J-CE/womo-energie-zentrale/src/config.h

#pragma once
#define FW_VERSION "5.6.7"
#define DEFAULT_TZ                  "CET-1CEST,M3.5.0,M10.5.0/3"   // Europe/Berlin
#define SERIAL_BAUD                 115200
#define UART_BMS_PORT               1
#define UART_BMS_RX                 16
#define UART_BMS_TX                 17
#define UART_BMS_BAUD               115200
#define UART_MPPT_PORT              2
#define UART_MPPT_RX                38
#define UART_MPPT_TX                42          // neu v5.0 (war -1)
#define UART_MPPT_BAUD              19200
#define GPIO_WR_LED_POWER           4     // Power-LED (grün), über Spannungsteiler
#define GPIO_WR_LED_ALARM           5     // Alarm-LED (rot),  über Spannungsteiler
#define WR_LED_ACTIVE               HIGH  // nach Messung ggf. auf LOW ändern
#define SPI_SD_CS                   11
#define SPI_SD_CLK                  12
#define SPI_SD_MOSI                 13
#define SPI_SD_MISO                 14
#define I2C_RTC_SDA                 1
#define I2C_RTC_SCL                 2
#define LEVEL_I2C_ADDR_PRIMARY      0x1D        // SA0=1 (Default-Breakout)
#define LEVEL_I2C_ADDR_ALT          0x1C        // SA0=0
#define LEVEL_POLL_INTERVAL_MS      250         // 4 Hz — flüssiges Leveling
#define LEVEL_TOLERANCE_DEG         1.2f        // |roll|,|pitch| darunter = eben
#define GPIO_LANDSTROM_SENSOR       18          // INPUT, Spannungsteiler 2k/1,5k von 5V, HIGH = Landstrom
#define GPIO_RELAY_D_PLUS           21          // Active-HIGH (Joy-it COM-MOSFET)
#define RELAY_D_PLUS_ACTIVE         HIGH
#define GPIO_MOSFET_GEL             39          // Active-HIGH (JTAG-MTCK, USB-JTAG aktiv)
#define MOSFET_GEL_ACTIVE           HIGH
#define GPIO_OPTO_WR_REMOTE         40          // Active-HIGH (JTAG-MTDO)
#define OPTO_WR_ACTIVE              HIGH
#define GPIO_STATUS_LED             41          // Active-HIGH (JTAG-MTDI)
#define GPIO_RGB_LED                48
#define RGB_LED_BRIGHTNESS              40          // 0–255 globale Helligkeit
#define RGB_SOC_GAUGE_CRIT_PCT      10          // < diesem SoC → SoC-Slot rot (kritisch)
#define RGB_SOC_GAUGE_LOW_PCT       20          // < diesem SoC → SoC-Slot orange
#define RGB_SOC_GAUGE_MID_PCT       40          // < diesem SoC → SoC-Slot gelb, sonst grün
#define WIFI_AP_SSID                "GODMODULE"
#define WIFI_AP_PASSWORD            "BM-hy678"
#define WIFI_AP_CHANNEL             6
#define WIFI_AP_MAX_CLIENTS         3
#define WEBSERVER_PORT              80          // WS auf /ws, gleichem Port
#define MDNS_HOSTNAME               "womo"      // → http://womo.local
#define NTP_SERVER                  "pool.ntp.org"
#define BLE_DEVICE_NAME             "WomoEnergy" // Advertising-Name
#define DEFAULT_BLE_ENABLED         1            // NVS-Default: an
#define BLE_PREF_MTU                517          // max. MTU-Angebot (Client handelt)
#define BLE_RX_LINE_MAX             256          // max. Kommandozeile (Byte)
#define BLE_RX_QUEUE_LEN            4            // RX-Queue-Tiefe (Zeilen)
#define BLE_BUFFER_MIN_MTU          100          // "buffer" nur ab dieser MTU
#define BLE_TX_RETRY_MAX            40           // Sendeversuche je Chunk
#define BLE_TX_RETRY_DELAY_MS       10           // Backoff zwischen Versuchen
#define BLE_MAX_NOTIFY_LEN          512          // Android-Notify-Hardlimit
#define LOG_BUFFER_SIZE             86400       // 48h @ 2s = 86400 Einträge
#define LOG_FILE_PREFIX             "/"         // /log_NNNNN.csv (NNNNN = Tage UTC)
#define WDT_TIMEOUT_MS              4000
#define BMS_POLL_INTERVAL_MS        2000
#define BMS_FRAME_MAX_LEN           320
#define BMS_FRAME_HEADER_1          0x4E
#define BMS_FRAME_HEADER_2          0x57
#define BMS_CURRENT_MODE            0
#define BMS_CURRENT_SCALE           0.01f       // A/Bit (Doku: 0.01A/Bit)
#define BMS_STALE_TIMEOUT_MS        60000       // 60s (L-SW03/04/05)
#define BMS_PLAUSIBLE_V_MIN           5.0f      // V  (4S LFP: nie sinnvoll darunter)
#define BMS_PLAUSIBLE_V_MAX          20.0f      // V  (deutlich über 4S-LFP-Ladeschluss)
#define BMS_PLAUSIBLE_I_MAX_A       400.0f      // A  (|Strom|; 280Ah-Zelle, reichlich Marge über 1C)
#define BMS_PLAUSIBLE_T_MIN         -50.0f      // °C (jk_temp-Formel erlaubt rechnerisch mehr als sinnvoll)
#define BMS_PLAUSIBLE_T_MAX         100.0f      // °C (Doku-Range 0x80-0x82: -40…100°C)
#define MPPT_FRAME_TIMEOUT_MS       3000        // Text-Protokoll Timeout
#define MPPT_HEX_TEMP_REGISTER      0x2003      // Battery temperature sense
#define MPPT_HEX_TEMP_NA            0x7FFF      // N/A-Wert wenn keine gültigen Daten
#define MPPT_HEX_SEND_INTERVAL_MS   10000       // 10s << 60s Timeout
#define DEFAULT_SOC_D_PLUS_ON           95      // % EIN-Schwelle
#define DEFAULT_SOC_D_PLUS_OFF          80      // % harte AUS-Schwelle
#define DEFAULT_PV_D_PLUS_MIN_W        100      // W Mindest-PV (ODER Float)
#define DEFAULT_SOC_GEL_ON              95      // % EIN-Schwelle
#define DEFAULT_SOC_GEL_OFF             80      // % harte AUS-Schwelle (neu v5.5)
#define DEFAULT_PV_GEL_MIN_W            20      // W Mindest-PV (v5.5: 60→20W)
#define DEFAULT_SOC_WR_OFF              80      // %
#define DEFAULT_RELAY_DEBOUNCE_CYCLES   10      // Zyklen × 2s = 20s Stabilität
#define DEFAULT_MANUAL_TIMEOUT_MIN      30      // min Deadman (nur EIN, nur D+/Gel)
#define LOGIC_PPV_MA_WINDOW             15      // Samples × 2s = 30s MA-Fenster
#define LOGIC_MPPT_RECOVERY_MIN          5      // valide Frames nach Timeout (≈ 10s)
#define DEFAULT_LOG_INTERVAL_MS     900000      // 15 Minuten SD-Batch
#define DEFAULT_TRACK_MM            1800        // mm Spurweite
#define DEFAULT_WHEELBASE_MM        3500        // mm Radstand
