J-CE/womo-energie-zentrale/src/main.cpp

// ============================================================
//  main.cpp — Womo Energy Core v5.6.0
//  v5.6.0: BLE-Init (ble_init nach webserver_init). Der 2s-Tick
//  in webserver_broadcast() bedient WS UND BLE (http_server.cpp).
//
//  Watchdog (zweistufig):
//   • HW-WDT (esp_task_wdt, 4s) überwacht loop() → harter Reboot
//   • SW-WDT (watchdog.cpp) überwacht BMS/MPPT/Logger
//
//  Tasks:
//   Core 1 | Prio 4: logic_task    (BMS poll + Logik, alle 2s)
//   Core 1 | Prio 3: mppt_task     (VE.Direct lesen + HEX-TX Temp)
//   Core 0 | Prio 2: logger_task   (SD flush, alle 5s)
//   Core 0 | Prio 2: ws_task       (WS+BLE broadcast/tick, alle 2s)
//   Core 0 | Prio 1: watchdog_task (watchdog.cpp)
// ============================================================

#include <Arduino.h>
#include <esp_task_wdt.h>
#include "config.h"
#include "params.h"
#include "bms.h"
#include "mppt.h"
#include "inverter.h"
#include "io.h"
#include "logic.h"
#include "logger.h"
#include "http_server.h"
#include "watchdog.h"
#include "clock.h"
#include "level.h"
#include "ota.h"
#include "ble.h"

static TaskHandle_t h_logic  = nullptr;
static TaskHandle_t h_mppt   = nullptr;
static TaskHandle_t h_logger = nullptr;
static TaskHandle_t h_ws     = nullptr;
static TaskHandle_t h_level  = nullptr;

// ── BMS abfragen + Logik (Core 1, 2s-Takt) ───────────────────
static void logic_task(void*) {
    TickType_t last = xTaskGetTickCount();
    for (;;) {
        watchdog_kick(WDT_BMS);
        if (!bms_poll()) Serial.println("[MAIN] BMS: kein Frame");
        logic_evaluate();
        logger_append();
        vTaskDelayUntil(&last, pdMS_TO_TICKS(BMS_POLL_INTERVAL_MS));
    }
}

// ── MPPT VE.Direct lesen + HEX-TX Temperatur (Core 1) ────────
// HEX-TX alle MPPT_HEX_SEND_INTERVAL_MS (10s)
static void mppt_task(void*) {
    uint32_t last_hex_tx = 0;
    for (;;) {
        watchdog_kick(WDT_MPPT);
        mppt_poll();
        inverter_poll();

        // BMS-Kerntemperatur periodisch an MPPT senden (HEX-TX, Register 0x2003)
        // Timeout MPPT: 60s → Intervall 10s ausreichend
        if ((uint32_t)(millis() - last_hex_tx) >= MPPT_HEX_SEND_INTERVAL_MS) {
            // Zellentemperatur (0x82 "battery temperature") senden
            // NOT tempMOS (0x80 "power tube") — der MPPT braucht Akkutemp!
            float cell_temp = 0.0f;
            bool  bms_valid = false;
            if (xSemaphoreTake(g_bmsMutex, pdMS_TO_TICKS(10)) == pdTRUE) {
                cell_temp = g_bms.tempSensor2;   // 0x82 = Zellentemperatur
                bms_valid = g_bms.valid &&
                    (uint32_t)(millis() - g_bms.lastUpdateMs) < BMS_STALE_TIMEOUT_MS;
                xSemaphoreGive(g_bmsMutex);
            }
            if (bms_valid) {
                // Zellentemperatur → MPPT Register 0x2003
                mppt_send_temperature(cell_temp);
            } else {
                // BMS veraltet/ungültig → N/A senden (0x7FFF)
                // MPPT fällt sofort auf interne Temperaturmessung zurück
                mppt_send_temp_na();
            }
            last_hex_tx = millis();
        }
        vTaskDelay(pdMS_TO_TICKS(100));
    }
}

// ── Logger SD flush (Core 0, alle 5s) ────────────────────────
static void logger_task(void*) {
    for (;;) {
        watchdog_kick(WDT_LOGGER);
        logger_flush_sd();
        vTaskDelay(pdMS_TO_TICKS(5000));
    }
}

// ── WebSocket Broadcast (Core 0, alle 2s) ────────────────────
static void ws_task(void*) {
    TickType_t last = xTaskGetTickCount();
    for (;;) {
        webserver_broadcast();
        vTaskDelayUntil(&last, pdMS_TO_TICKS(2000));
    }
}

// ── Task-Erzeugung mit Rückgabeprüfung ───────────────────────
// Ein fehlgeschlagenes xTaskCreatePinnedToCore (i.d.R. Heap-Mangel für den
// Stack) ist deterministisch: es scheitert bei jedem Boot gleich. Daher KEIN
// abort()/restart() (→ Boot-Loop, remote nicht diagnostizierbar), sondern laut
// loggen und weiterlaufen — der Webserver kommt hoch, der Fehler ist sichtbar.
static bool start_task(BaseType_t rc, const char* name) {
    if (rc != pdPASS) {
        Serial.printf("[MAIN] FEHLER: Task '%s' nicht erstellt (Heap?)\n", name);
        return false;
    }
    return true;
}

void setup() {
    Serial.begin(SERIAL_BAUD);
    // K-1: USB-CDC verwirft TX-Daten statt zu blockieren, wenn kein Host
    // liest (Normalfall im Womo-Betrieb ohne angeschlossenen PC). Ohne das
    // kann Serial.write() die aufrufende Task bis zum TX-Timeout blockieren —
    // fatal, wenn das im gehaltenen g_bmsMutex passiert (→ SW-WDT-Reboot).
    Serial.setTxTimeoutMs(0);
    delay(500);

    Serial.println("\n╔═══════════════════════════════╗");
    Serial.println("║   GODMODULE — Energy Core     ║");
    Serial.printf ("║   Womo Energy Core v%-10s║\n", FW_VERSION);
    Serial.println("╚═══════════════════════════════╝\n");

    io_init();
    io_rgb_init();        // RGB-LED auf weiß (Boot-Lebenszeichen)
    params_init();
    bms_init();
    mppt_init();          // UART2 RX=38 TX=42
    inverter_init();
    logic_init();
    logger_init();
    clock_init();
    level_init();         // Lagesensor (optional) — nach clock_init: Wire + g_i2cMutex bereit
    webserver_init();
    ble_init();           // v5.6.0: BLE GATT-Server (NUS) — falls NVS ble/en=1
    ota_init();           // Boot-Diagnose: laufende/nächste OTA-Partition loggen

    // F-01: Rückgabe jeder Task-Erzeugung prüfen. Alle Creates werden versucht
    // (kein Short-Circuit), damit im Fehlerfall ALLE Ausfälle sichtbar werden.
    bool tasks_ok = true;
    tasks_ok &= start_task(xTaskCreatePinnedToCore(logic_task,  "logic",  8192, nullptr, 4, &h_logic,  1), "logic");
    tasks_ok &= start_task(xTaskCreatePinnedToCore(mppt_task,   "mppt",   4096, nullptr, 3, &h_mppt,   1), "mppt");
    tasks_ok &= start_task(xTaskCreatePinnedToCore(logger_task, "logger", 6144, nullptr, 2, &h_logger, 0), "logger");  // K-4: SD-Aufrufkette tief
    // v5.6.0: ws-Stack 4096→6144 — ble_tick() läuft im ws_task und legt
    // StaticJsonDocument<512> + Zeilenpuffer (256 B) auf den Stack.
    tasks_ok &= start_task(xTaskCreatePinnedToCore(ws_task,     "ws",     6144, nullptr, 2, &h_ws,     0), "ws");
    tasks_ok &= start_task(xTaskCreatePinnedToCore(level_task,  "level",  4096, nullptr, 1, &h_level,  0), "level");
    if (!tasks_ok)
        Serial.println("[MAIN] WARNUNG: Nicht alle Tasks gestartet — System läuft eingeschränkt.");

    // F-01: Rückgabe prüfen. Auf Arduino-Core 2.x kann der TWDT bereits vom
    // Core initialisiert sein → esp_task_wdt_init liefert dann ESP_ERR_INVALID_STATE
    // (Timeout wird NICHT rekonfiguriert). Das ist tolerierbar, aber sichtbar loggen.
    esp_err_t wdtErr = esp_task_wdt_init(WDT_TIMEOUT_MS / 1000, true);
    if (wdtErr != ESP_OK && wdtErr != ESP_ERR_INVALID_STATE)
        Serial.printf("[MAIN] esp_task_wdt_init: %s\n", esp_err_to_name(wdtErr));
    esp_task_wdt_add(nullptr);
    watchdog_init();

    io_rgb_task_start();  // LED-Render-Task (übernimmt RGB ab jetzt)

    io_blink_status_led(3, 100, 100);
    Serial.println("[MAIN] Alle Tasks gestartet");
    Serial.printf("[MAIN] Heap: %u B  PSRAM: %u B\n",
                  ESP.getFreeHeap(), ESP.getFreePsram());
}

void loop() {
    esp_task_wdt_reset();
    ota_tick();           // geplanter OTA-Neustart (Sicherung + ESP.restart)
    uint32_t freeHeap = ESP.getFreeHeap();
    // Nicht-blockierend: Flag setzen, der LED-Task zeigt Magenta-Burst.
    // (Früher blockierte io_blink_status_led() hier bis 450ms in loop().)
    g_rgbHeapAlert = (freeHeap < 20480);
    if (g_rgbHeapAlert)
        Serial.printf("[MAIN] WARNUNG: Heap niedrig: %u B\n", freeHeap);
    vTaskDelay(pdMS_TO_TICKS(1000));
}
