J-CE/womo-energie-zentrale/(commit log)

2026-06-25 Initial commit: Womo Energy Core v5.0
    [partitions_16mb.csv]
2026-06-25 README hinzugefügt, Lastenheft + Anschlussanleitung auf v5.1 aktualisiert (DS3231, CAN-BMS-Alternative, RGB-Rundlauf)
2026-06-25 Case.scad hinzugefügt
    [Case.scad]
2026-06-26 Clock auf Zeizonen umgestellt, Gehäuse optimiert
    [Case.scad]
2026-06-26 bugfix newlib hat kein tm_gmtoff-Feld
    [clock.cpp]
2026-06-26 Verbindung mit externem WLAN hinzugefügt, Landstrom HIGH / LOW korrigiert
    [config.h, http_server.cpp, http_server.h, io.cpp, io.h]
2026-06-27 Case Platinenauflage fixed
    [Case.scad]
2026-06-27 feat(lage): optionale elektronische Wasserwaage (MMA8452)
    - level.cpp/.h: MMA8452-Treiber, Neigung via atan2, Keilberechnung
    (hoechstes Rad = Referenz, keil_i = max(z) - z_i)
    - gemeinsamer I2C-Bus-Mutex g_i2cMutex (clock.cpp) fuer DS3231 + Sensor
    - API /api/level, /api/levelcfg, /api/levelcalib + Live-JSON
    - Dashboard-Tab 'Lage' (Libelle + Keilhoehen je Rad)
    - eigener NVS-Namespace 'level', keine Aenderung am Bestandsverhalten
2026-06-30 Inverter auf Renogy aktualisiert, BMS direkt über GPS Port angeschlossen, da RS485 über MAX485 am CAN/RS485 Port nicht funktionierte
    [Case.scad]
2026-07-02 Womo Energy Core v5.4 — Wiederherstellung
2026-07-03 V5.4.1 OTA - update
    [partitions_16mb.csv]
2026-07-03 v5.5 Kriterien-Redesign + D+-Pegel-Fix (Active-HIGH) + Lagesensor flipZ/Fehlertoleranz + persistentes Manuell-AUS
    [config.h, http_server.cpp, io.cpp, io.h, level.cpp, level.h, logic.cpp, logic.h]
2026-07-03 v5.5.1 Multi-SSID Heim-WLAN (3 Slots, Scan-basierte Auswahl, NVS-Migration)
2026-07-05 npt und womo.local
2026-07-07 v5.6.2: BLE-TX-Fix — Direkt-Notify umgeht 512-B-Attributlimit (Live-/Buffer-Frames bei MTU 517 korrupt)
    [ble.cpp, config.h]
2026-07-10 v5.6.5: BMS-Frame-Parsing deterministisch, WLAN-Status bei BLE
